qb-creates/boost-converter-TLV61070ADBVR/README.md

# boost-converter-TLV61070ADBVR
Simple boost converter using the Texas Instrument TLV61070ADBVR
