qb-creates/boost-converter-TLV61070ADBVR/BoostConverter-TLV61070ADBVR/BoostConverter-TLV61070ADBVR.kicad_pcb

## KiCad design BoostConverter-TLV61070ADBVR/BoostConverter-TLV61070ADBVR.kicad_pcb (2024-06-27)

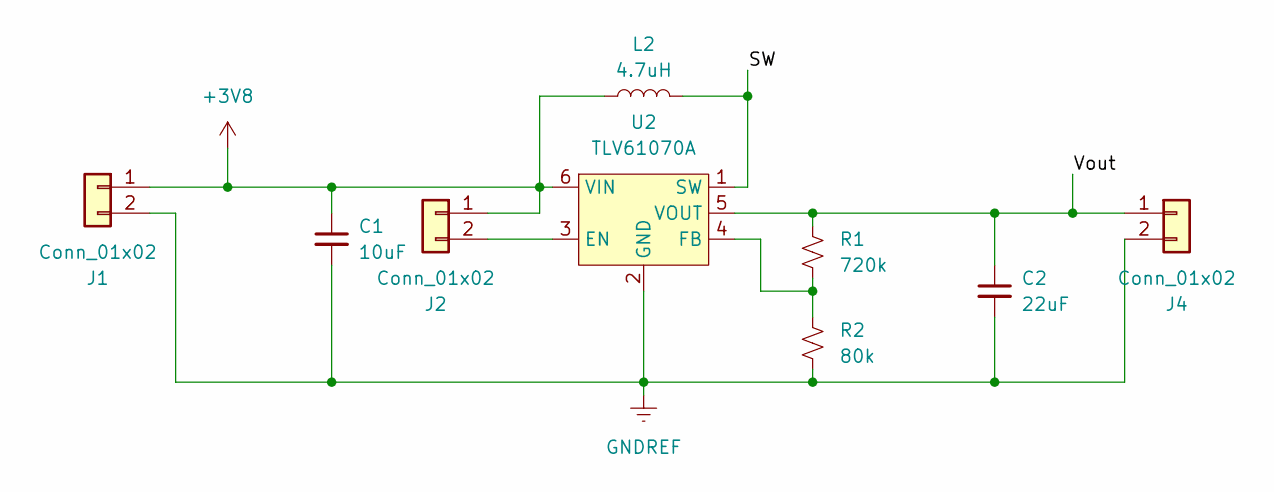
[picture p1: schematic BoostConverter-TLV61070ADBVR.kicad_sch]

Parts:
C1: 10uF; C_1206_3216Metric
C2: 22uF; C_1206_3216Metric
J1, J2, J4: Conn_01x02; PinHeader_1x02_P2.54mm_Vertical
L2: 4.7uH; Bourns SRP30xx
R1: 720k; R_0603_1608Metric_Pad0.98x0.95mm_HandSolder
R2: 80k; R_0603_1608Metric
U2: TLV61070A; SOT-23-6

Connections:
+3V8: C1.1, J1.1, J2.1, L2.1, U2.6 (VIN)
/SW: L2.2, U2.1 (SW)
/Vout: C2.1, J4.1, R1.1, U2.5 (VOUT)
GNDREF: C1.2, C2.2, J1.2, J4.2, R2.2, U2.2 (GND)
unnamed: J2.2, U2.3 (EN)
unnamed: R1.2, R2.1, U2.4 (FB)

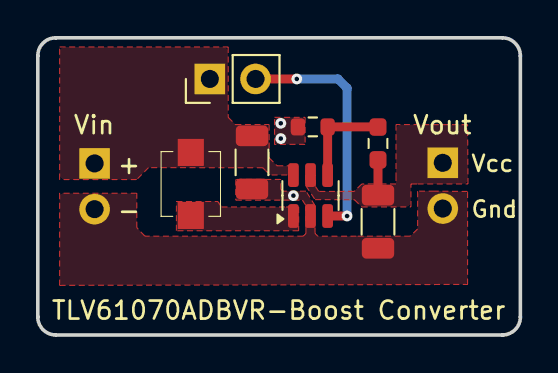
[picture p2: board BoostConverter-TLV61070ADBVR.kicad_pcb from above]

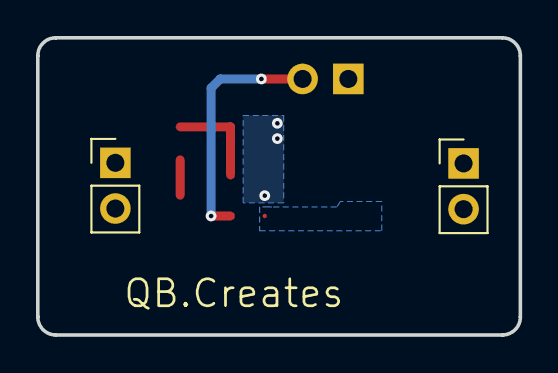
[picture p3: board BoostConverter-TLV61070ADBVR.kicad_pcb from below]

Board: 2 copper layers, 26.8 x 16.5 mm, 9 parts (2 on the bottom side), 6 nets.
