qb-creates/boost-converter-TLV61070ADBVR/(commit log)

2024-06-27 Adding project to the repo
    [BoostConverter-TLV61070ADBVR-B_Cu.gbl, BoostConverter-TLV61070ADBVR-B_Mask.gbs, BoostConverter-TLV61070ADBVR-B_Paste.gbp, BoostConverter-TLV61070ADBVR-B_Silkscreen.gbo, BoostConverter-TLV61070ADBVR-Edge_Cuts.gm1, BoostConverter-TLV61070ADBVR-F_Cu.gtl, BoostConverter-TLV61070ADBVR-F_Mask.gts, BoostConverter-TLV61070ADBVR-F_Paste.gtp]
2024-08-11 Added correct datasheet to the inductor. Added the inductor part number to the description
    [BoostConverter-TLV61070ADBVR.kicad_sch]
